cansat-tsniimash/gravitsapa-2.1-2023-2024/Readme.txt

Если порядковый номер компонента (Designator) на схеме обозначен оранжевым цветом, то данный компонент не установлен на плату.
