cansat-tsniimash/gravitsapa-2.1-2023-2024/src/documents/Гравицапа-2.0/ГРАВИЦАПА_ЧЕРНОВИК.pptx

## ГРАВИЦАПА

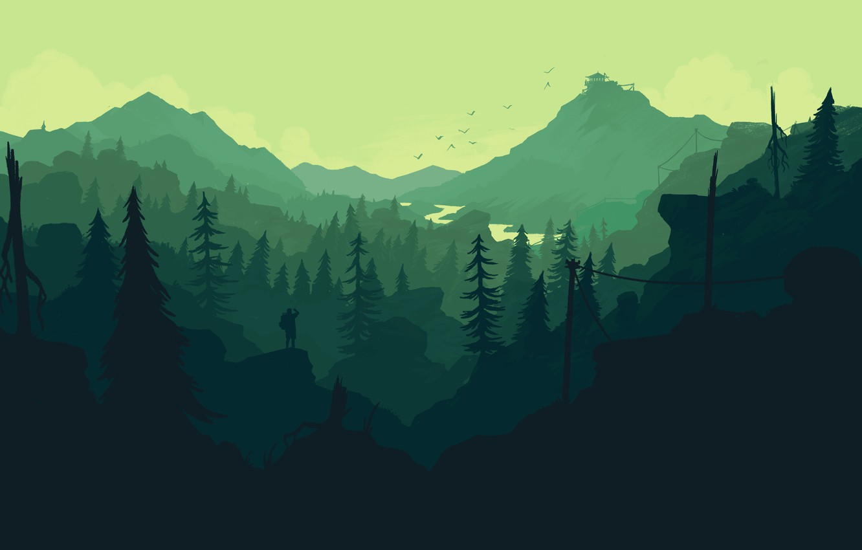
[picture p3: figure]

Капитан, программист – Мирослав Алексеев
Конструктор – Владислав Перепелко
Схемотехник – Роман Каширский
Программист - Иван
Куратор – прохор прошаков

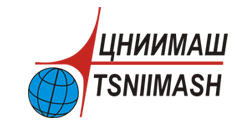
[picture p4: figure]

2023-2024 гг.

## Миссия аппарата

- Наш аппарат предназначен для помощи спасателям в поисковых операциях. По задумке, некоторое кол-во подобных аппаратов сбрасывается с вертолета на участок предполагаемого нахождения потерявшегося. При приземлении, аппарат начинает подавать световые и звуковые сигналы, чтобы их можно было легко найти потерявшемся. После нахождения, человек, нажав на кнопку, подает сигнал на базу спасателей, о том, что аппарат нашли. Одновременно на экране на боку аппарата включается навигатор, который укажет направление к месту спасения для потерявшегося.


## Блок-схема бортовых систем аппарата

Сигнализация

SD-карта

GPIO

Фотодатчик

Сдвиговый регистр
74HC595

светодиоды

кнопки

OLED-дисплей
SSD1309 12864

SDIO

I2C

Микроконтроллер
STM32F401R

Термометр
DS18B20U

SPI

1Wire

Магнитометр
LIS3MDL

Барометр BME280

Акселерометр +
Гироскоп(LSM6DSL)

UART

GPS- приёмник
ATGM336H

## Питание

## Slide 5

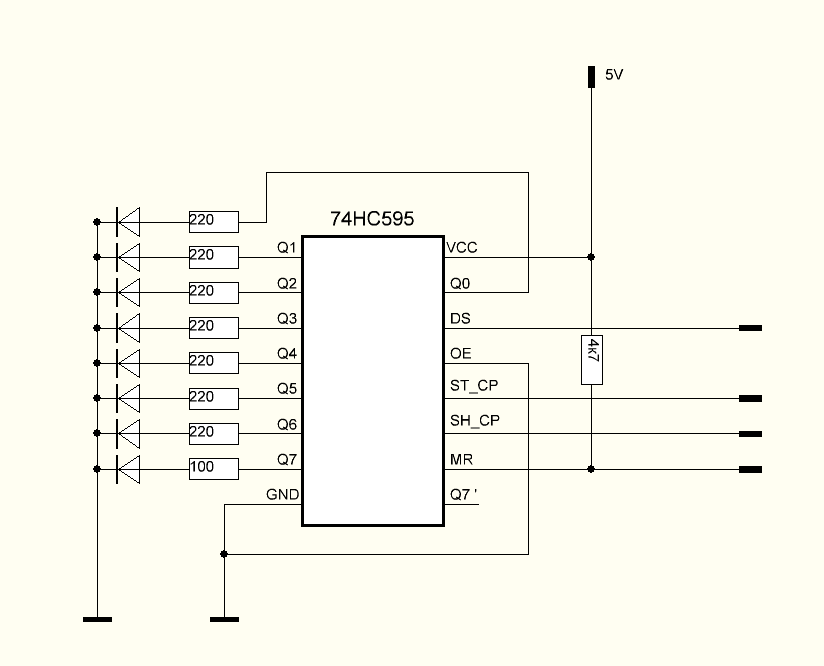
[picture p5: figure]

## Slide 6

Алгоритм работы аппарата
