cansat-tsniimash/gravitsapa-2.1-2023-2024/README.md

# gravitsapa-2.1-2023-2024
Репозиторий гравитсапы
