cansat-tsniimash/gravitsapa-2.1-2023-2024/src/documents/Гравицапа-2.0/ГРАВИЦАПА_РЫБА.pptx

## ГРАВИЦАПА

Капитан, программист – Мирослав Алексеев
Конструктор – Владислав Перепелко
Схемотехник – Роман Каширский
Программист – Иван Смалько

## Миссия аппарата

- Краткое описание доп. миссии

## Описание миссии (продолжение)

## Конструкция аппарата

- Описание конструкции с изображениями

## Блок-схема основных бортовых систем

- Блок-схема аппарата с кратким описанием

## Энергобаланс + бюджеты по массе и по стоимости

- таблица

## Формула расчёта парашюта

- Слайд с формулой и выкройкой сектора купола парашюта

## План-график работ по проекту

## Спасибо!
