cansat-tsniimash/gravitsapa-2.1-2023-2024/src/documents/Гравицапа-2.0/OLED-дисплей.jpg

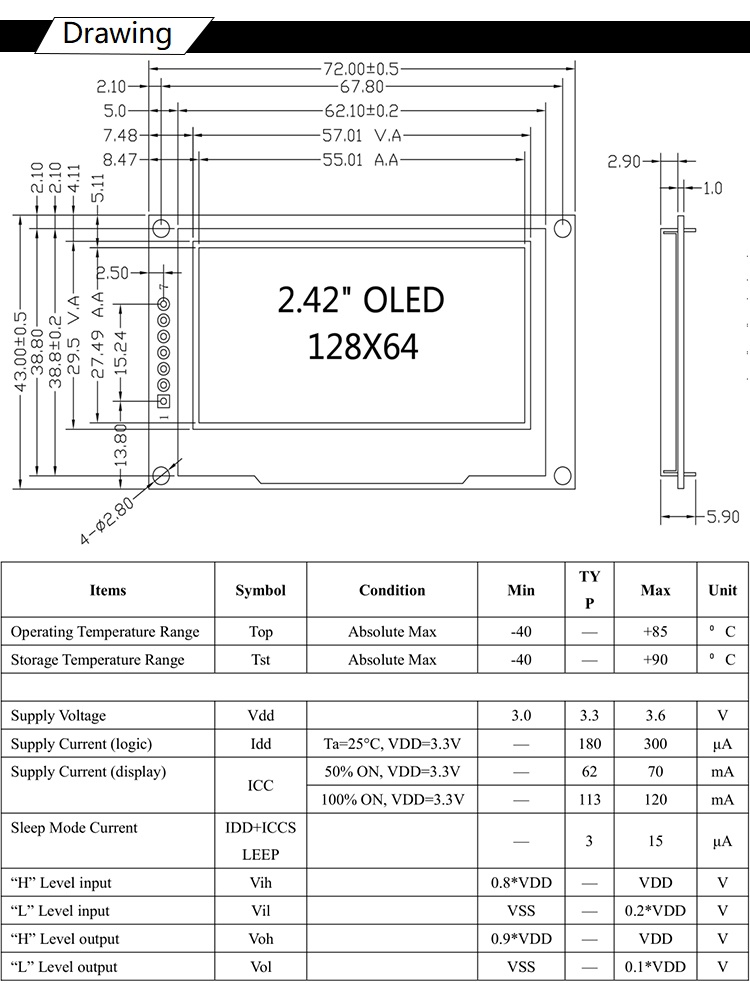
src/documents/Гравицапа-2.0/OLED-дисплей.jpg
