cansat-tsniimash/gravitsapa-2.1-2023-2024/src/documents/Гравицапа-2.0/Новый список закупок.xlsx

Компонент: | Модель: | Цена: | Кол-во: | Стоимость: | Ссылка:
OLED-дисплей | SSD1309 12864 | 861.20 ₽ | 1 | 861.20 ₽ | https://aliexpress.ru/item/1005006088294885.html?sku_id=12000035677387813
пьезоизлучатель 1 | Пьезоэлектрическая сигнализация для защиты от кражи | 340.82 ₽ | 1 | 340.82 ₽ | https://aliexpress.ru/item/1005002754796016.html?sku_id=12000032028523735
пьезоизлучатель 2 | динамик 125 дБ 12 в электрический | 171.19 | 1 | 171.19 ₽ | https://aliexpress.ru/item/4000001833647.html?sku_id=10000000001350917
Светодиод DC 12 В (10 ШТ) | red 5mm | 107.13 | 2 | 214.26 ₽ | https://aliexpress.ru/item/32959874956.html?sku_id=66406095518
КомпАс | Компас для дайвинга KANPAS | 1178.38 | 1 | 1178.38 ₽ | https://aliexpress.ru/item/836832746.html?sku_id=12000034769273263
конструктор регулярной лиги | ? |  | 1 | 0.00 ₽
элементы питания 18650 | Liitokala 18650, 3400 мАч | 298.27 | 2 | 596.54 ₽ | https://aliexpress.ru/item/32366428568.html?sku_id=65702391952
Чехол для аккумулятора 18650 | 2-18650 | 10.5 | 1 | 10.50 ₽ | https://aliexpress.ru/item/4001192853672.html?sku_id=10000015258295656
Водонепроницаемый кнопочный переключатель 12 мм | YELLOW | 33.2 | 1 | 33.20 ₽ | https://aliexpress.ru/item/10000335736442.html?sku_id=20000000175774975
Яркий пластик для 3D-принтера | PLA пластик Меч джедая, флуоресцентный 1кг | 1298 | 1 | 1298.00 ₽ | https://www.fdplast.ru/produkcziya/plastik-dlya-3d-pechati/plastik-dlya-3d-printera/pla-plastik-mech-dzhedaya-fluorestsentnyy-1kg/
DC DC преобразователь (12В) | Модуль повышения напряжения Lith-Battery Boost (8 штук) | 276 | 1 | 276.00 ₽ | https://aliexpress.ru/item/1005006095774972.html?sku_id=12000035720661086
полевой транзистор (N канальный) | 2n7000 (20 шт.) | 107 | 1 | 107.00 ₽ | https://aliexpress.ru/item/1005005274933054.html?sku_id=12000032447602264
набор макетных плат | PCB KIT (20 шт.) | 731 | 1 | 731.00 ₽ | https://aliexpress.ru/item/32831489775.html?sku_id=65033054802
набор резисторов | Металлические пленочные резисторы 1/4 Вт | 239 | 1 | 239.00 ₽ | https://aliexpress.ru/item/32698175464.html?sku_id=12000033298621757
фотодатчик | 4-pin Photosensitive Sensor Module (3 шт.) | 138 | 1 | 138.00 ₽ | https://aliexpress.ru/item/1005006103494793.html?sku_id=12000035756919711
карабин для парашюта | 16 мм внутр. Расстояние | 95 | 1 | 95.00 ₽ | https://aliexpress.ru/item/1005004210259028.html?sku_id=12000028390356845
набор крепежа М2 | 280 штук набор | 624 | 1 | 624.00 ₽ | https://aliexpress.ru/item/32907505613.html?sku_id=10000007795644036
набор крепежа М3 | 220 штук набор | 702 | 1 | 702.00 ₽ | https://aliexpress.ru/item/32907505613.html?sku_id=10000007795644037
набор крепежа М2+М2.5+М3 | 250PCS SET | 288 | 1 | 288.00 ₽ | https://aliexpress.ru/item/1005002426046826.html?sku_id=12000020776755059
сдвиговый регистр | 74HC595DIP (10 шт.) | 56 | 1 | 56.00 ₽ | https://aliexpress.ru/item/1005002852895130.html?sku_id=12000022468282899
 |  |  |  | 7960.09 ₽
 |  |  | 0
