cansat-tsniimash/gravitsapa-2.1-2023-2024/(list of files, drawings)

Other design files:
src/documents/Гравицапа-2.0/Splan70/Файлы/Chip.spl7
src/documents/Гравицапа-2.0/Splan70/Файлы/elements.spl7
src/documents/Гравицапа-2.0/Splan70/Файлы/Parent-Child.spl7
src/documents/Гравицапа-2.0/Splan70/Шаблоны/A4_Landscape_1.spl7
src/documents/Гравицапа-2.0/Splan70/Шаблоны/A4_Landscape_2.spl7
src/documents/Гравицапа-2.0/Splan70/Шаблоны/A4_Landscape_3.spl7
src/documents/Гравицапа-2.0/Splan70/Шаблоны/A4_Landscape_4.spl7
src/documents/Гравицапа-2.0/Splan70/Шаблоны/A4_Portrait_1.spl7
src/documents/Гравицапа-2.0/Splan70/Шаблоны/A4_Portrait_2.spl7
