cansat-tsniimash/gravitsapa-2.1-2023-2024/src/board/Application/aZimut.h

/*
 * aZimut.h
 *
 *  Created on: May 31, 2024
 *      Author: kamepiula
 */

#ifndef AZIMUT_H_
#define AZIMUT_H_

double get_azimuth_deg(
		double base_lon_deg, double base_lat_deg, double my_lon_deg, double my_lat_deg
);

#endif /* AZIMUT_H_ */
