cansat-tsniimash/gravitsapa-2.1-2023-2024/(commit log)

2023-10-18 Создал новую репу, добавил оновные папки.
2023-10-20 Написал\переписал БАЗУ. скопипастил драйвера для бме, лсм. Пытался протестить, но нет норм данных. Скорее всего это из-за того что я не понимаю где прописывать и как прописывать пины, с которыми надо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
2023-10-25 Добавил чип селект, но не на сдвиговый регистр..... короче если добавить, то заработает я думаю
2023-10-27 шо то сделал с сидвиговым регистром, но по сути ничего не сделал
2023-10-28 0 ероров ура, правда один хардфолт, короче надо заполнить структуру и норм будет -_-
    [A4_Landscape_1.spl7, A4_Landscape_2.spl7, A4_Landscape_3.spl7, A4_Landscape_4.spl7, A4_Portrait_1.spl7, A4_Portrait_2.spl7, Chip.spl7, Parent-Child.spl7]
2023-11-01 Сдвиговый регистр сидел на другом спи, настроили работает, но на бмешки нули, финал уже близок я надеюсь
2023-11-03 Завел бмеху, запрогал и завел лсмку, сюдаааааааааgit status! Пятница-раскумарица спасает, ну и Маша кнчн
2023-11-04 сюдаааа! запрогал лиску, все работает вместе, пришлось править драйвер для лиски. суббота - раскумарица топ!
2023-11-08 Запрогал и завел DS18B20, не без помощи Маши конечно. Короче надо было настроить частоты нормальные и нормально стало.
2023-11-10 Написао тест радио, разложил все по папочкам, пятницп раскумарица каеф
2023-11-26 Написал код для GPS, не смог протестить т.к. не помню как смотреть UART, по коду вроде все норм
2023-11-29 НАписал кодик на норм вывод с юарта в консоль, гпс не словил, возмодно чтото с кодом на гпс так как никто не чекал его(((
2023-12-01 НАписал норм gps, добавил прерывания, пока что нет фикса(((
2023-12-16 Коммит перед переустановкой CubeIDE
2024-01-10 гг файлы слетели, откатываюсь
2024-02-14 тяжело(...
2024-03-02 Переписал заново код красивенько. Сиправил все ошибки
2024-03-22 Написал тест экранчика, добавил готовый дравер на него. В тысячный раз перепроверил настройки радио... | Василий, я вас очень жду
2024-03-23 Василий - сигма волшебник, починил радио и гпс. Thank you very much Vasiliy. Составил структур-файл с пакетами, объявил их в аппмейне + присвоил им флаги
2024-03-27 Написал состав пакетов + парсер, Радио отлично работает, в парсере надо поправить размеры пакетов
2024-03-29 Дописал радио, все работает, только под конец какая-то задержка появилась
2024-03-30 Переписал состояние радио, тест светодиодов провален. Зато гпс работает вместе с радио. Пятница-раскумарица пошла напользу
2024-04-05 Некоторые изменения, начал писать СД
2024-04-09 Дрписал функции в условиях записи на СД, не помогло, записывается только один пакет и то не очень нормально
2024-04-26 Че то я там писал, уже не помню что, но SR работает SD ща буду писать пятница-раскумарица
2024-04-27 попытался завести кнопку - провал, я устал, я ухожу Z ZVO Какой хороший день чтоб пойти на SVO
2024-04-28 Василий перписал весь код, ГПС не тестили, радио робит, датчики робят, сд робит, экран не тестили, светодиоды тоже
2024-05-09 НАписал Василий экранчик, графика работает .осталось только алгоритм правилный написать
2024-05-17 С Василием написали время с гпс на экран, доюавили фичи для определения наличия фикса и нажата ил нет кнопка ресет
2024-05-25 Вычисление расстояния работает идельно!!!
    [A4_Landscape_1.spl7, A4_Landscape_2.spl7, A4_Landscape_3.spl7, A4_Landscape_4.spl7, A4_Portrait_1.spl7, A4_Portrait_2.spl7, Chip.spl7, Parent-Child.spl7]
2024-05-31 Стрелка работает, но корявенько
2024-06-05 Костыли с состояниями, фотодатчик фигово работает, написал светодиоды\
2024-06-07 Пофиксил 3 осевые, ножку светодатчика выбрал другую
2024-06-08 коммит перед чекаутом
